croepha/the-bike-shed/(threads)

Thread 3 (2021-06-23):

Unlockable with iPhone

tmelanson17, 2021-06-23:
Explore why it doesn't work when an iPhone is used. Could phone access be something separate entirely?

mentarus, 2021-08-12:
Unfortunately in iOS only Apple are allowed to do Host Card Emulation (be a target) for Apple Pay where they pretend to be contactless bank card to contactless bank terminals which are only initiator's.

croepha, 2021-08-13:
I have a PN532 dev board, if anyone wants to look into seeing if that works better, it can function as both an initiator and a target

Thread 5 (2021-06-23):

Potential port to the COR1A "Buoy" chips

tmelanson17, 2021-06-23:
The are dual core Arm chips
need a custom firmware to boot from, has u-boot
so can load from network
and probably re-flash via serial

https://www.noisebridge.net/wiki/COR1A

tmelanson17, 2021-06-23:
https://fccid.io/2AP38-COR1A/Internal-Photos/Internal-Photos-3915270.pdf

tmelanson17, 2021-06-23:
A53 1.6 GHz chip, datasheet
https://www.nxp.com/part/LS1043ASE7QQB#/
quad core

Closed 2021-06-23.

Thread 6 (2021-08-12):

Separate the exterior and interior schematics

mentarus, 2021-08-12:
This would make it MUCH easier to annotate a PCB layout

croepha, 2021-08-13:
Yes this sounds good

croepha, 2021-08-14:
done in https://github.com/croepha/the-bike-shed/commit/9c1dd410525a1573f2934e736b353837ac8e8d2e

Closed 2021-08-14.

Thread 7 (2021-08-12):

Replace switches and LEDS with 4 pin connectors

mentarus, 2021-08-12:
Would make back annotation much easier for PCB layout

croepha, 2021-08-13:
This sounds good

croepha, 2021-08-15:
done in https://github.com/croepha/the-bike-shed/commit/a82b8fcfdaa64347e3041a293284cfce8794b4b6

Closed 2021-08-15.
