croepha/the-bike-shed/schematics/schematics.sch

## KiCad design schematics/schematics.sch (2020-11-30)

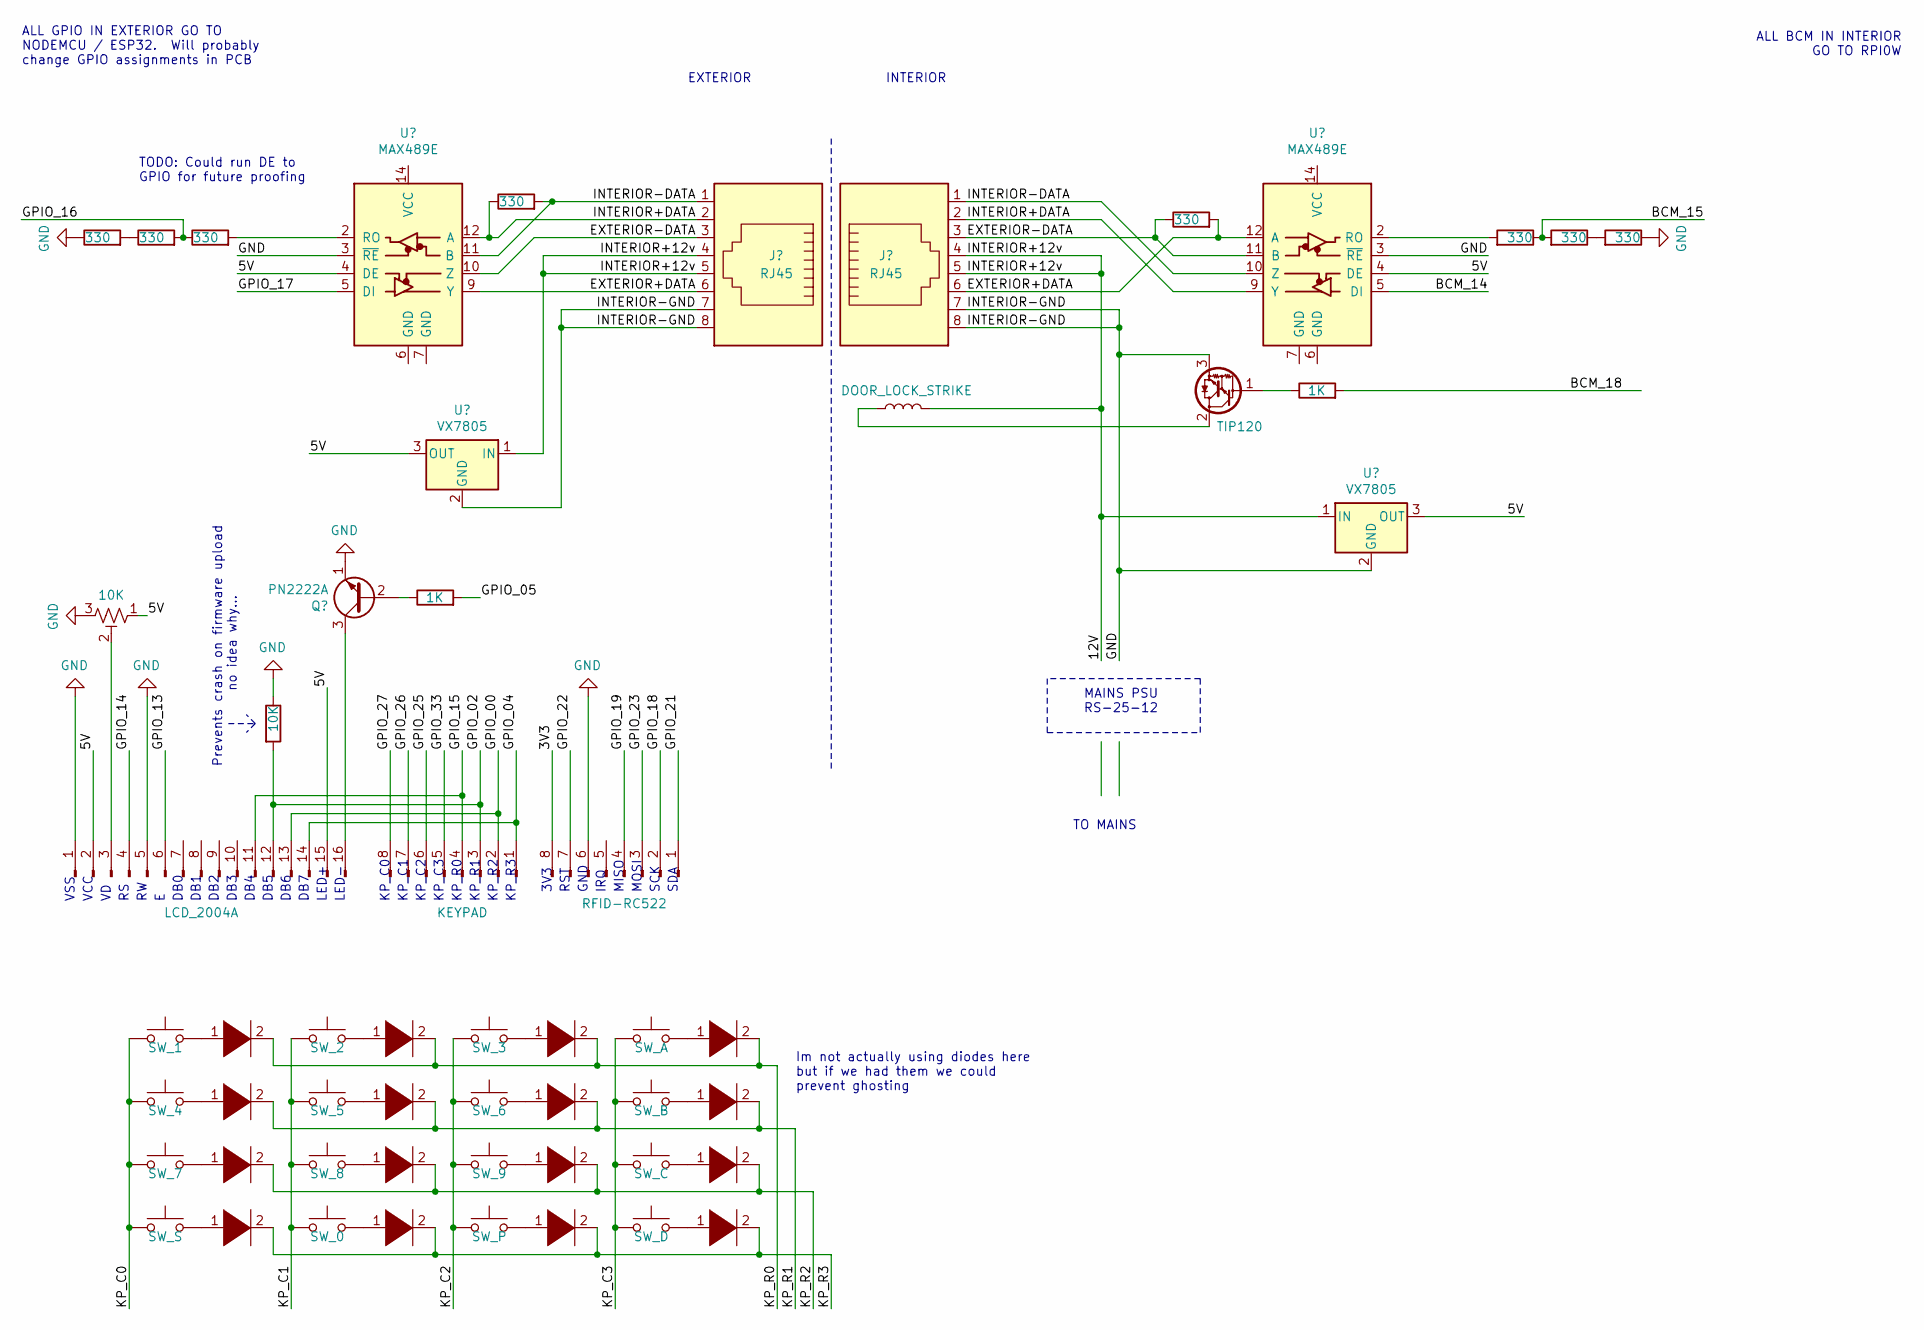
[picture p1: schematic schematics.sch]

Parts:
DOOR_LOCK_STRIKE: L
LCD_2004A: Conn_01x16_Male
SW_0, SW_1, SW_2, SW_3, SW_4, SW_5, SW_6, SW_7, SW_8, SW_9: SW_SPST
SW_A: SW_SPST
SW_B: SW_SPST
SW_C: SW_SPST
SW_D: SW_SPST
SW_P: SW_SPST
SW_S: SW_SPST

Connections:
5V: LCD_2004A.2, LCD_2004A.15
12V: DOOR_LOCK_STRIKE.2
GND: LCD_2004A.1, LCD_2004A.5
GPIO_00: LCD_2004A.13
GPIO_02: LCD_2004A.12
GPIO_04: LCD_2004A.14
GPIO_13: LCD_2004A.6
GPIO_14: LCD_2004A.4
GPIO_15: LCD_2004A.11
KP_C0: SW_1.1, SW_4.1, SW_7.1, SW_S.1
KP_C1: SW_0.1, SW_2.1, SW_5.1, SW_8.1
KP_C2: SW_3.1, SW_6.1, SW_9.1, SW_P.1
KP_C3: SW_A.1, SW_B.1, SW_C.1, SW_D.1

Notes on the sheet:
INTERIOR
EXTERIOR
MAINS PSU RS-25-12
TO MAINS
SDA
RST
GND
IRQ
MISO
MOSI
SCK
3V3
KP_C0
KP_R2
KP_R1
KP_R0
KP_C3
KP_C2
KP_C1
KP_R3
VSS
DB0
VCC
DB1
DB2
DB3
DB4
DB5
DB6
DB7
LED+
LED-
ALL GPIO IN EXTERIOR GO TO NODEMCU / ESP32. Will probably change GPIO assignments in PCB
ALL BCM IN INTERIOR GO TO RPI0W
Prevents crash on firmware upload no idea why…
Im not actually using diodes here but if we had them we could prevent ghosting
TODO: Could run DE to GPIO for future proofing
