croepha/the-bike-shed/schematics/exterior/exterior.sch

## KiCad design schematics/exterior/exterior.sch (2021-08-15)

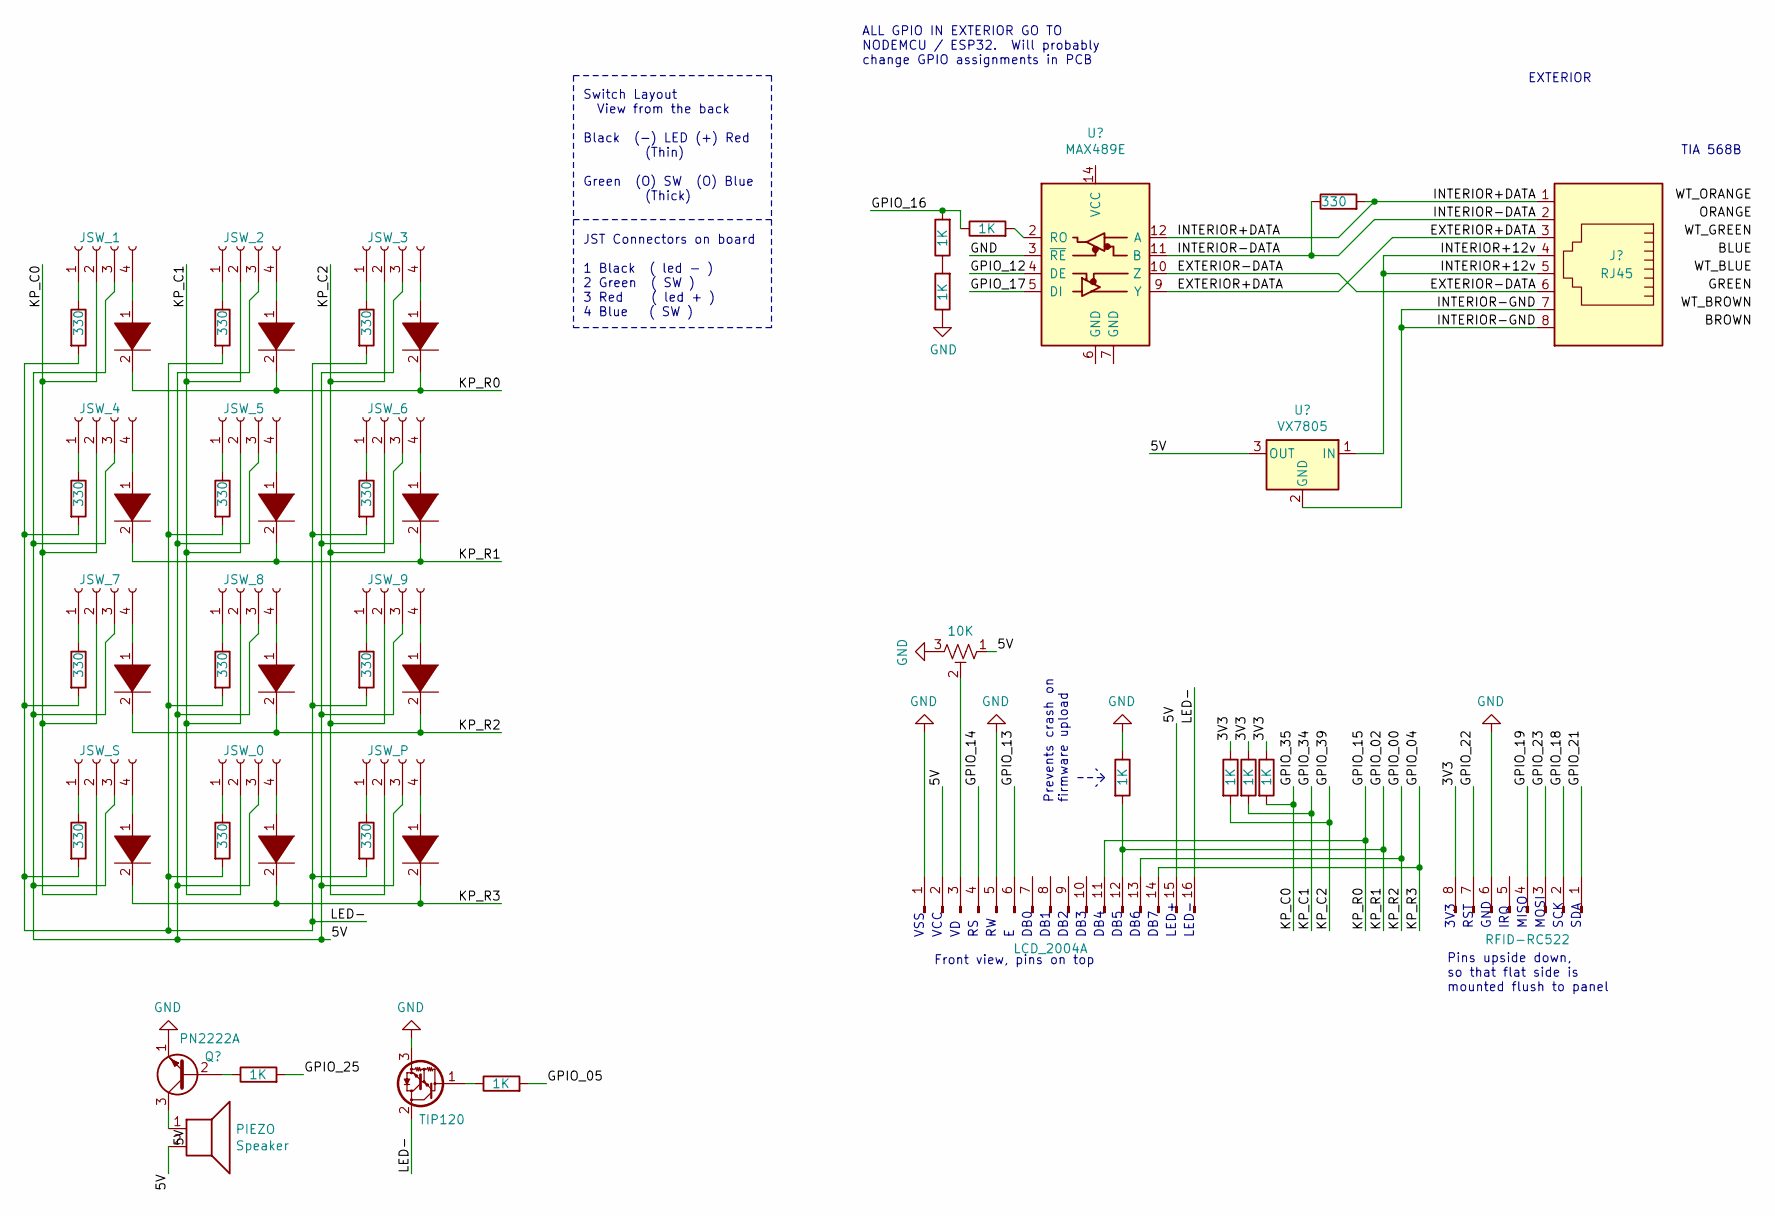
[picture p2: schematic exterior.sch]

Parts:
JSW_0, JSW_1, JSW_2, JSW_3, JSW_4, JSW_5, JSW_6, JSW_7, JSW_8, JSW_9: Conn_01x04_Female
JSW_P: Conn_01x04_Female
JSW_S: Conn_01x04_Female
LCD_2004A: Conn_01x16_Male
PIEZO: Speaker

Connections:
5V: JSW_0.3, JSW_1.3, JSW_2.3, JSW_3.3, JSW_4.3, JSW_5.3, JSW_6.3, JSW_7.3, JSW_8.3, JSW_9.3, JSW_P.3, JSW_S.3, LCD_2004A.2, LCD_2004A.15, PIEZO.2
GND: LCD_2004A.1, LCD_2004A.5
GPIO_00: LCD_2004A.13
GPIO_02: LCD_2004A.12
GPIO_04: LCD_2004A.14
GPIO_13: LCD_2004A.6
GPIO_14: LCD_2004A.4
GPIO_15: LCD_2004A.11
GPIO_34: JSW_0.2, JSW_2.2, JSW_5.2, JSW_8.2
GPIO_35: JSW_1.2, JSW_4.2, JSW_7.2, JSW_S.2
GPIO_39: JSW_3.2, JSW_6.2, JSW_9.2, JSW_P.2
LED-: LCD_2004A.16

Notes on the sheet:
EXTERIOR
SDA
RST
GND
IRQ
MISO
MOSI
SCK
3V3
VSS
DB0
VCC
DB1
DB2
DB3
DB4
DB5
DB6
DB7
LED+
LED-
ALL GPIO IN EXTERIOR GO TO NODEMCU / ESP32. Will probably change GPIO assignments in PCB
TIA 568B
Front view, pins on top
Pins upside down, so that flat side is mounted flush to panel
Prevents crash on firmware upload
Switch Layout View from the back Black (-) LED (+) Red (Thin) Green (O) SW (O) Blue (Thick) JST Connectors on board 1 Black ( led - ) 2 Green ( SW ) 3 Red ( led + ) 4 Blue ( SW )
