croepha/the-bike-shed/access.h

#pragma once
#include "common.h"

static usz const SALT_BUF_LEN = 64;
static usz const rfid_LEN = 24;
static usz const pin_LEN  = 10;

struct access_HashPayload {
  u8 salt [SALT_BUF_LEN];
  u8 rfid [rfid_LEN    ];
  u8 pin  [pin_LEN     ];
};

enum access_expire_day_magics {
  access_expire_day_magics_Adder       = (u16)-1,
  access_expire_day_magics_Extender    = (u16)-2,
  access_expire_day_magics_NewAdder    = (u16)-3,
  access_expire_day_magics_NewExtender = (u16)-4,
};

typedef u16 access_user_IDX;
enum {
  access_user_NOT_FOUND = (u16)-1,
};


typedef u8 access_HashResult[32];

struct accessUser {
  u8 debug_is_free;
  union {
    struct {
        access_HashResult hash;
        u16 expire_day;
    };
  };
  access_user_IDX next_idx;
} extern access_users_space[];

enum accessFlags {
  access_OLD_SALT = 1
};

void __access_hash(access_HashResult result, struct access_HashPayload * payload);
void access_hash(access_HashResult hash, char * rfid, char * pin, enum accessFlags flags);

char const * access_user_add(access_HashResult hash, u16 expire_day, u8 require_existing, u8 overwrite_admin);
void access_user_list_init(void);
void access_idle_maintenance(void);
access_user_IDX   access_user_lookup(access_HashResult hash);
extern access_user_IDX * access_idle_maintenance_prev;
extern access_user_IDX access_users_first_idx;
u16 access_now_day(void);
s32 access_user_days_left(access_user_IDX USER_idx);
u8 access_user_is_admin(access_user_IDX USER_idx);
void access_prune_not_new(void);

extern char access_salt_old[];
extern char access_salt[];
