croepha/the-bike-shed/(commit log)

2020-05-08 Switch to CC0
    Addresses jurisdictions where relinquishment of copyright is not a thing.
2020-05-09 schematics stash
    [schematics.kicad_pcb, schematics.sch]
2020-05-10 Worked on schematic
    [schematics.sch]
2020-05-10 schematic notes
    [schematics.sch]
2020-05-25 all kinds of changes to random stuff
    [schematics.sch]
2020-09-14 esp32 stash
2021-06-22 Tweaks to decrease size: removed kernel debug symbols and stripped mount_squash_root
2021-08-11 updated to verson 2 of hardware
    [exterior2.sch, schematics.kicad_pcb]
2021-08-14 separated the interior and exterior schematics
    [exterior.sch, exterior2.sch, interior.sch]
2021-08-15 Reworked keypad so that it has connectors
    [exterior.sch]
2021-09-07 Adding some notes about possible scheduling issues
    [io_core.c]
2021-09-26 io refactor wip broken?
    [io.h, io_core.c, io_curl.c, serial_io.c, supervisor_io.c]
2021-11-15 Everything works except the adding 30 day process, will fix that later
    [exterior.c, exterior.ino, state_machine.c]
